ydwww/EC464_Team15_Betterbot/Software_report.md

Since we are a pure hardware project, the only software involve in our project is LTspice, which is analog electronic circuit simulator produced by Analog Device and it can be downloaded from [LTspice download](https://www.analog.com/en/design-center/design-tools-and-calculators/ltspice-simulator.html).

For beginner, a detailed tutorial can be found [tutorial link](https://www.analog.com/en/education/education-library/videos/video-series/ltspice-getting-started-tutorial.html).

## Brief Tutorial
After downloading the LTspice, you can create a new schematic by opening it up and choosing to start a new, blank schematic. The next step is placing components. From the toolbar, you can place any components you want and place it on the schematic. By using command+R (mac) or ctrl+R (window), you can rotate the components to coordinate with your circuit. After placing the components you need, you will need to give value based such as resistance and capacitance. If you need to use transistors, you should also pick the type. LTspice has a few built in transistors such as 2N2222 or PN4416. Any other transistors can be found online by simply searching for its product name and "spice model". Then we can go to the website and copy the model. In LTspice, we can add the spice model by editing the SPICE directive and change the transistor to the specific type we want. After placing all the components and giving them values, you need to wire all the components together. The last step is to run the simulation by clicking the run button and setting the analysis type and its parameters. Then you will be able to see the output of your circuit.

## Improved Schematic
There are five circuit files to simulate in LTSpice for this project:

1. Active Antenna
2. Isolation Amplifier
3. Tracking Filter
4. Triode Mixer

All the circuits are improved version. The original circuit schematics can be downloaded from [betterbots](http://www.betterbots.com/). 

By downloading them, you can open them up in LTspice. Then click the **run** button, you will see the output of each circuits. 

## Analysis Type in LTspice
LTspice offers a few different analysis types such as transient, AC analysis, DC analysis. In our project, we mainly used AC analysis because we are improving an AM radio system and AC analysis is aim to analyzing the frequency response. AC analysis can be used to calculate the gain, phase shift, and frequency response and the output is also shown in the bode plot. AC analysis have multiple scaling: liner, octave, and decade. Each one provides a different number of simulation points and setting frequency. Decade scaling (dec) is our major choice. One decade is equivalent to a ratio of 10. We also used DC analysis in order to get the voltage level and current at different position of the circuit. Since for most of the circuits, we are using transistors thus we always expect the emitter voltage to be smaller than the power voltage and prevent the transistor from saturating. By using the DC analysis, we are able to find the emitter voltage and then we can compare it with the actual value to check if our circuit is built properly. Transient analysis is used when we want to compare the ideal signal with the actual prototype output. Transient analysis is a time domain analysis that shows the output of the behavior over time. Since the time domain is also usually shown in the oscilloscope, we always use transient analysis for output comparison. From the comparison, we can tell whether the circuit works properly or if there is any clipping or noise caused by other components of the circuits.

# LTSpice set up for each circuit
After watching the tutorials we provided in an earlier section, we assume that the user will have the ability to simulate and choose components from the LTSpice, the following will be just a guide on which simulation commands the user necessary to run for each circuit.

## Active Antenna Spice Setup

The active antenna schematic is shown in the figure below:



The active antenna will only use AC simulation, the command is shown below:



After the user runs the simulation, right click on the output of the antenna, the following bode plot of the antenna will display:



## Isolation Amplifier Setup

The improved isolation Amplifier schematic is shown in the figure below:



The isolation amplfiier will use AC, Noise, and Transient Analysis as part of the project.

To begin with The AC analysis will show the gain of the amplifier, the command of the AC analysis is shown below:



After the user simulates the circuit, left click on the output of the amplifier where the node label as (o), the following bode plot should show up:



The second command will be the noise simulation, the command of the noise simulation is shown below:



After the user simulates the circuit, right click on the output screen and find add trace and select gain and vinose then click ok to see the output:





The third command will require a current input source (remove AC voltage source and replace it with a current source (set the ac value to 1)) for example:



The purpose of this simulation is to check the input impedence of the circuit.

The command and simulation output is shown below (to obtain the proper input impedance output, the user shown right click on the input section/node):




## Tracking Filter Setup

The improved tracking filter schematic is shown below:



The purpose of the tracking filter is to lock/set a specific am radio frequency detected nearby, to lock/select a radio frequency we need to adjust the capacitor (C4 in the circuit diagram) value.

The only command we are going to use in this circuit will be transient analysis, after running the simulation left click on the output of the tracking filter, the user should see a sharp peak at certain frequncy (by adjusting the variable capacitor C4) the detailed instruction is shown below.




## Triode Mixer Setup

The improved triode mixere schematic is shown below:



The triode mixer will use transient analysis and FFT as part of the project, after simulating the transient anaylsis, left click on the output of the mixer, and right click on the output screen find FFT, the FFT will show the intermediate frequency.
