ydwww/EC464_Team15_Betterbot/REPORT/REPORT_README.md

This section contains all the reports we have done for EC463 and EC464 including all the test plans and test reports which can help you to understand our process of validating the circuits.
