ydwww/EC464_Team15_Betterbot/SCHEMATICS/IsolationImprovedVersion3.asc

C1: cap; 10n
C2: cap; 1n
C3: cap; 10n
C4: cap; 1µ
C5: cap; 1µ
C6: cap; 1µ
Q1: npn; BFS17
Q2: npn; BFS17
Q3: npn; BC847C
R1: res; 10.5k
R2: res; 2.4k
R3: res; 1.6k
R4: res; 50k
R6: res; 5.4k
R7: res; 100
R8: res; 100
R9: res; 5k
R10: res; 100
R11: res; 50k; tol=50k
R12: res; 1k
R13: res; 100
R26: res; 10
V1: voltage; SINE(0 5m {freq}); AC 1
V2: voltage; 3.3
Named nets: 0, o
.MODEL  BFS17   NPN
+              IS = 2.26749E-016
+              BF = 4.27829E+001
+              NF = 9.98081E-001
+             VAF = 3.09206E+001
+             IKF = 2.80682E+000
+             ISE = 1.25812E-011
+              NE = 2.69052E+000
+              BR = 1.50821E+001
+              NR = 9.89755E-001
+             VAR = 1.31800E+001
+             IKR = 3.83070E-001
+             ISC = 6.22829E-016
+              NC = 1.08818E+000
+              RB = 1.00000E+001
+             IRB = 1.00000E-006
+             RBM = 1.00000E+001
+              RE = 3.00000E-001
+              RC = 2.76000E+000
+              EG = 1.11000E+000
+             XTI = 3.00000E+000
+             CJE = 8.93473E-013
+             VJE = 6.00000E-001
+             MJE = 2.81933E-001
+              TF = 1.03700E-010
+             XTF = 8.59092E+001
+             VTF = 4.16619E-002
+             ITF = 9.82771E-002
 +             CJC = 1.08829E-012
+             VJC = 4.07523E-001
.noise V(o) V1 dec 100k 0.5meg 1.5meg
.param freq=1MEG
.tran 10u
