ydwww/EC464_Team15_Betterbot/SCHEMATICS/Tracking_filter_final.asc

C1: cap; 1n
C2: cap; 1n
C3: cap; 1µ
C4: cap; 0.0755n
J1: njf; J113
L1: ind; 430µ
Q1: npn; BC550_NPN
Q2: npn; BC550_NPN
Q3: npn; BC550_NPN
R1: res; 7.87k
R2: res; 33k
R3: res; 1k
R4: res; 10
R5: res; 10
R6: res; 100
R7: res; 10k
R8: res; 10k
R9: res; 50.9k
R10: res; 22.9k
R11: res; 10k
R12: res; 100
R13: res; 70k
V1: voltage; ""; AC 10m
V2: voltage; 6
V3: voltage; 3.3
V4: voltage; 0.1
Named nets: 0, Out
.MODEL BC550_NPN NPN IS =1.8E-14 ISE=5.0E-14 NF =.9955 NE =1.46 BF =400
+BR =35.5 IKF=.14 IKR=.03 ISC=1.72E-13 NC =1.27 NR =1.005 RB =.56 RE =.6
+RC =.25 VAF=80 VAR=12.5 CJE=13E-12 TF =.64E-9 CJC=4E-12 TR =50.72E-9
+VJC=.54 MJC=.33 LEVEL=1
.ac dec 2000 100k 2meg
;tran 2000
To simulate a resistor range from 44.6kOHM to 1M OHM use a control voltage from 0.8V to 1V
.step param Vctrl 0 2 0.1
