ydwww/EC464_Team15_Betterbot/SCHEMATICS/modified_triode_mixer.asc

BiasVoltage: voltage; {VR2}
C1: cap; 0.1µ
C5: cap; 1µ
C6: cap; 1µ
C7: cap; 22p
C8: cap; 1n
C12: cap; 10µ
J1: njf; MMBFJ202
Q1: npn; BC847C
Q3: npn; BC847C
Q4: pnp; BC857C
Q5: pnp; BC857C
Q6: pnp; BC857C
R1: res; 220
R2: res; 100
R10: res; 5.9k
R11: res; 8.2k
R12: res; 10k
R13: res; 3.9k
R14: res; 50k
R15: res; 1k
R17: res; 10k
Rd: res; {VR1}
V1: voltage; SINE(1.1 0.05 1.005Meg)
V2: voltage; 1.1
V6: voltage; 3.3
V11: voltage; SINE(0 0.1 1Meg)
Named nets: 0, out2
.SUBCKT SMV1801 anode cathode
Ls anode 1 0.8E-9
Rs 1 2 1.1
D1 2 cathode SMV1801_int
Cp 1 cathode 2.6E-12
.MODEL SMV1801_int D
+ IS = 1.00E-14
+ RS = 0
+ N = 1
+ TT = 0
+ CJ0 = 85E-12
+ M = 4.4
+ VJ = 10
+ EG = 1.11
+ XTI = 3
+ KF = 0
+ AF = 1
+ FC = 0.5
+ BV = 30
+ IBV = 1E-3
+ ISR = 0
+ NR = 2
+ IKF = 0
+ NBV = 1
+ IBVL = 0
+ NBVL = 1
+ TBV1 = 0
+ TNOM = 27
.ENDS
.MODEL  BAV99  D
+ IS = 7.25E-09
+ RS = 0.85
+ N = 1.92
+ XTI = 3.0
+ EG = 1.11
+ CJO = 1.13E-12
+ M = 0.33
+ VJ = 0.75
+ FC = 0.5
+ TT = 3.62E-09
+ ISR = 7.74E-09
+ NR = 1.99
+ BV = 70.0
+ IBV = 1.0E-04
.param ctrl=5.731   ; 1.005MHz
.step param ctrl 1 16 1
.MODEL MMBFJ202 NJF
+ VTO=-3.95
+ BETA=0.00198
+ LAMBDA=0.0052
+ IS=1.1937E-12
+ ISR=3.7937E-13
+ NR=1
+ ALPHA=6.80E-6
+ VK=40
+ RD=18.049
+ RS=18.049
+ CGD=1.998e-012
+ CGS=1.258e-012
+ M=0.280
+ PB=0.515
+ KF=5.622e-018
+ AF=0.55664
+ BETATCE=-0.46
+ VTOTC=-2.1000E-3
.tran 0 2m 0 1n
.step param Cin LIST 1u 2u 4u 8u
.param Cin=10n
.param Cin=1u
.step param VRx LIST  1 2
.param VR1 table(VRx, 1, 40, 2, 150)
.param VR2 table(VRx, 1, -0.95, 2, 0)
