ydwww/EC464_Team15_Betterbot/SCHEMATICS/Modified Active Antenna.asc

C1: cap; 1µ
C2: cap; 1.5n
J1: njf; BF256B
Q1: npn; PN2222A
R1: res; 68k
R2: res; 100k
R3: res; 10k
R4: res; 1Meg
R5: res; 1.4k
V1: voltage; SINE(0 100m 1Me); AC 1
V2: voltage; 3.3v
Named nets: 0, Output1, output
.MODEL BF256B NJF(VTO=-2.3085 BETA=1.09045m BETATCE=-0.5 LAMBDA=2.31754E-2 RD=7.77648 RS=7.77648 CGS=2.00000p CGD=2.20000p PB=9.91494E-1 IS=2.59121E-16 XTI=3 AF=1 FC=0.5 N=1 NR=2 MFG=PHILIPS)
.ac dec 100 1 1G
output dc voltage is 1.452V
Vout1 = 2.48
.MODEL PN2222A  NPN (IS=2.20f NF=1.00 BF=240 VAF=114
+ IKF=0.293 ISE=2.73p NE=2.00 BR=4.00 NR=1.00
+ VAR=24.0 IKR=0.600 RE=0.194 RB=0.777 RC=77.7m
+ XTB=1.5 CJE=24.9p VJE=1.10 MJE=0.500 CJC=12.4p VJC=0.300
+ MJC=0.300 TF=371p TR=64.0n EG=1.12 )
.tran 0.1m
